Jan-V2/v3s_devboard/v3s_board.kicad_pcb

## KiCad design v3s_board.kicad_pcb (2022-10-17)

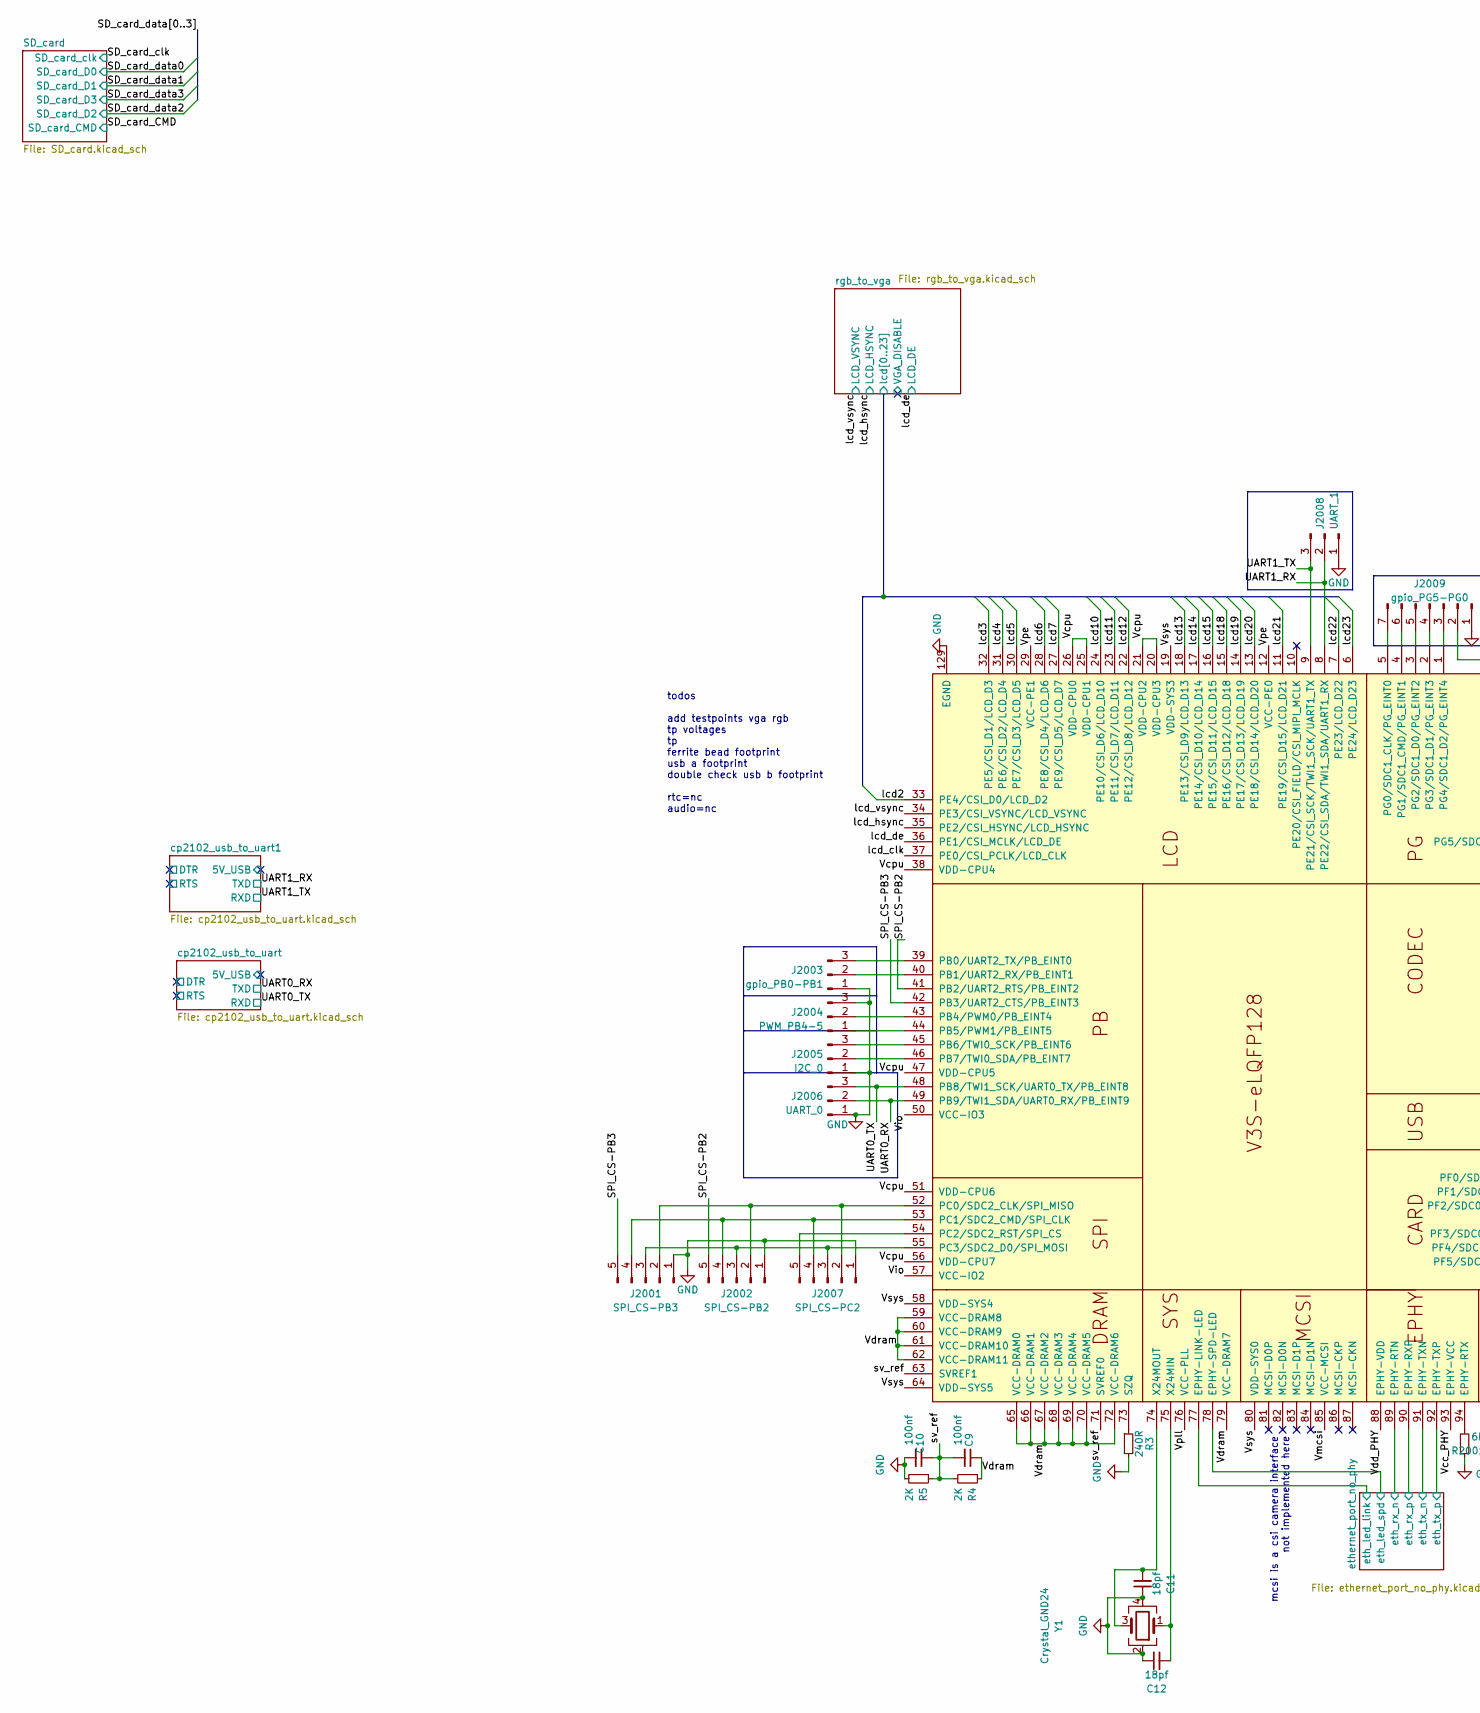
[picture p1: schematic v3s.kicad_sch, part in row 1, column 1]

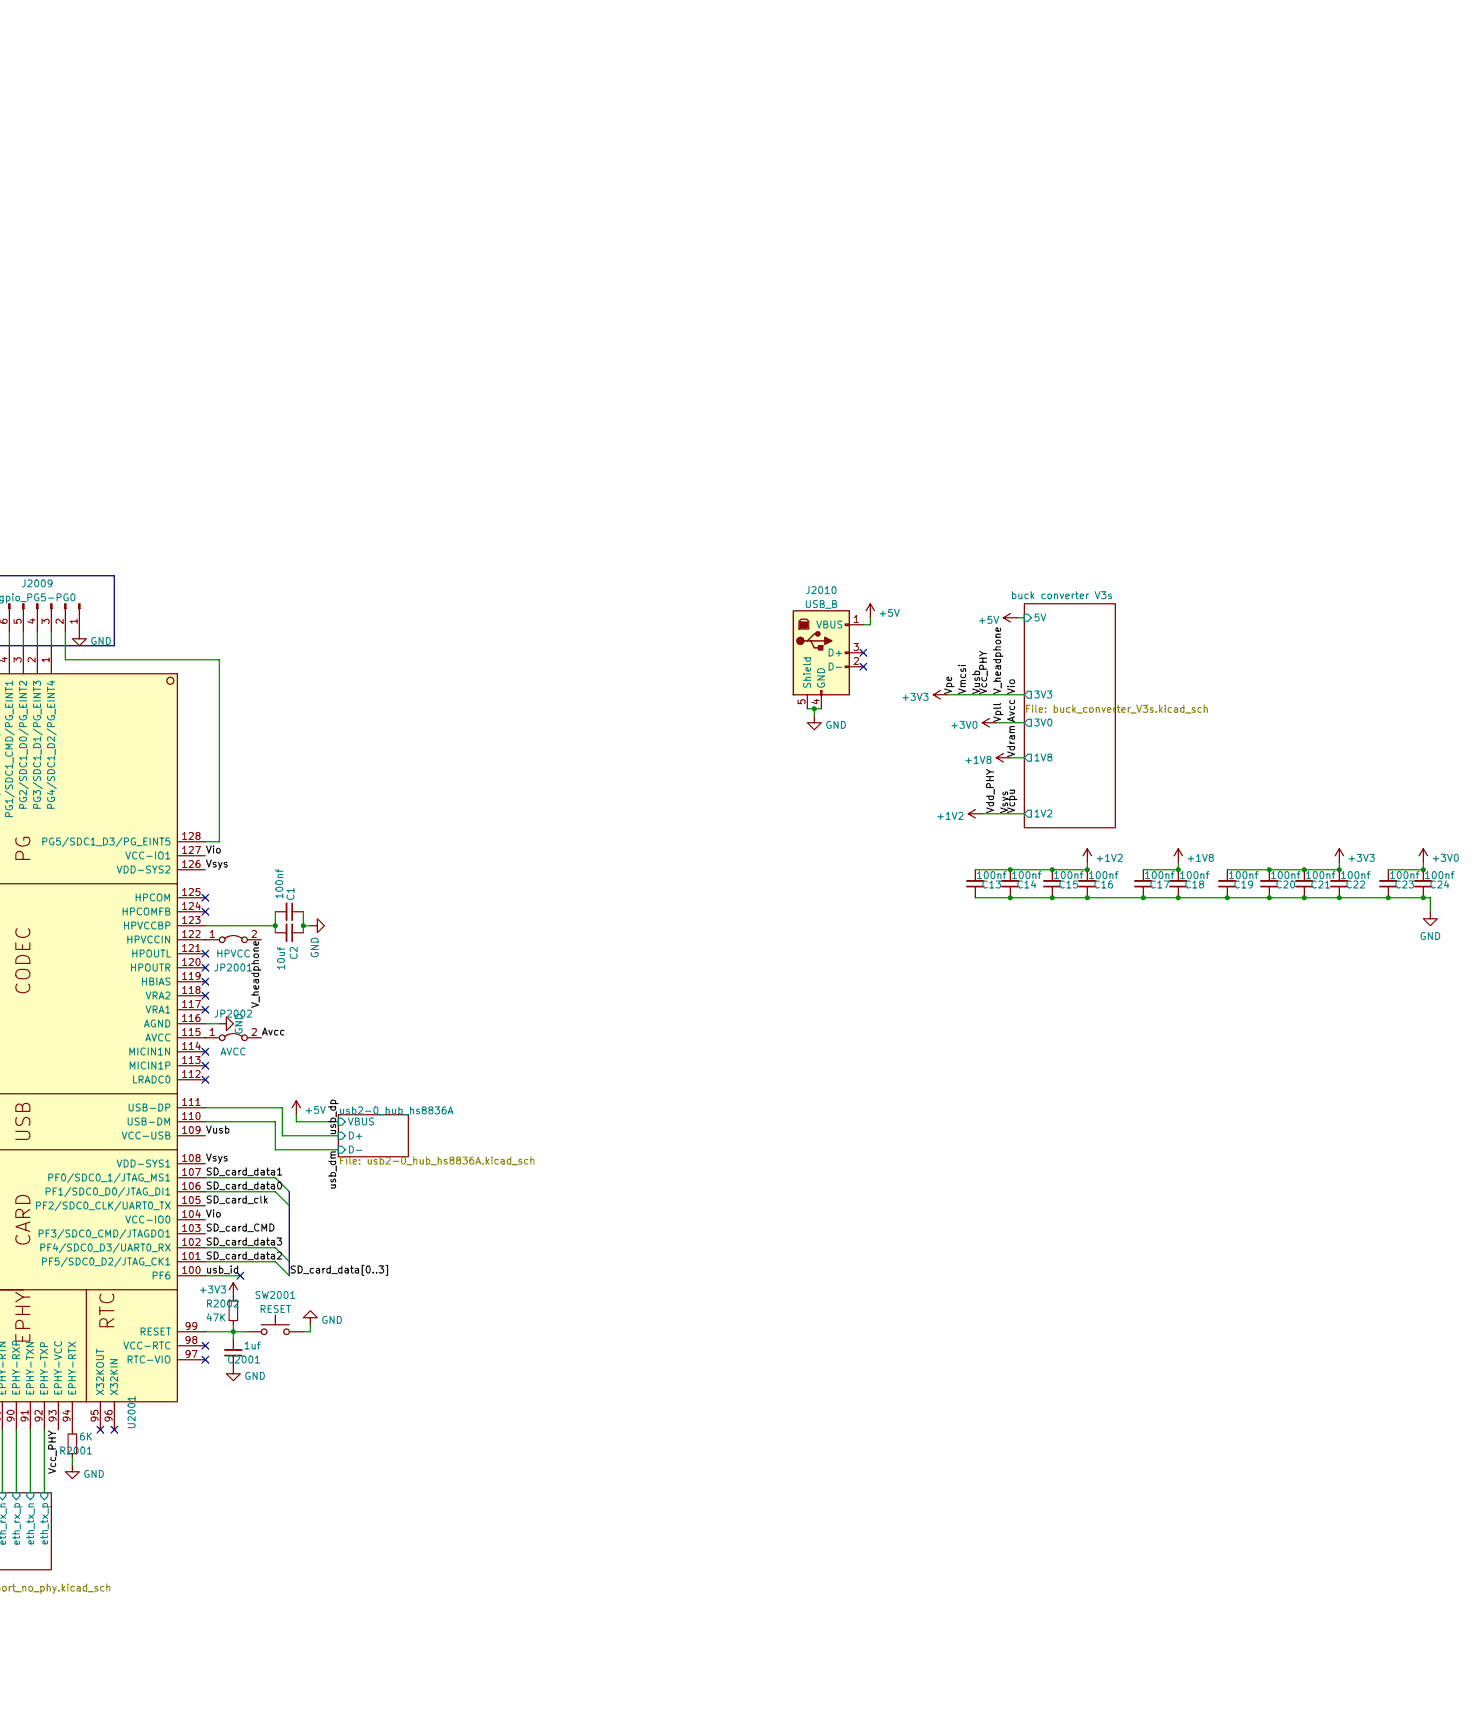
[picture p2: schematic v3s.kicad_sch, part in row 1, column 2]

Parts:
C1, C9, C10, C13, C14, C15, C16, C17, C18, C19, C20, C21, C22, C23, C24: 100nf; C_0603_1608Metric
C2: 10uf; C_0603_1608Metric
C11, C12: 18pf; C_0603_1608Metric
C2001: 1uf; C_0603_1608Metric
J2001: SPI_CS-PB3; PinHeader_1x05_P2.54mm_Vertical
J2002: SPI_CS-PB2; PinHeader_1x05_P2.54mm_Vertical
J2003: gpio_PB0-PB1; PinHeader_1x03_P2.54mm_Vertical
J2004: PWM_PB4-5; PinHeader_1x03_P2.54mm_Vertical
J2005: I2C_0; PinHeader_1x03_P2.54mm_Vertical
J2006: UART_0; PinHeader_1x03_P2.54mm_Vertical
J2007: SPI_CS-PC2; PinHeader_1x05_P2.54mm_Vertical
J2008: UART_1; PinHeader_1x03_P2.54mm_Vertical
J2009: gpio_PG5-PG0; PinHeader_1x07_P2.54mm_Vertical
J2010: USB_B; USB_B_TE_5787834_Vertical
JP2001: HPVCC; SolderJumper-2_P1.3mm_Bridged_Pad1.0x1.5mm
JP2002: AVCC; SolderJumper-2_P1.3mm_Bridged_Pad1.0x1.5mm
R3: 240R; R_0603_1608Metric
R4, R5: 2K; R_0603_1608Metric
R2001: 6K; R_0603_1608Metric
R2002: 47K; R_0603_1608Metric
SW2001: RESET; SW_PUSH_6mm
U2001: V3S; LQFP-128_14x14mm_P0.4mm
Y1: Crystal_GND24; Crystal_SMD_3225-4Pin_3.2x2.5mm_HandSoldering

Connections:
+1V2: C13.2, C14.2, C15.2, C16.2, U2001.19 (VDD-SYS3), U2001.20 (VDD-CPU3), U2001.21 (VDD-CPU2), U2001.25 (VDD-CPU1), U2001.26 (VDD-CPU0), U2001.38 (VDD-CPU4), U2001.47 (VDD-CPU5), U2001.51 (VDD-CPU6), U2001.56 (VDD-CPU7), U2001.58 (VDD-SYS4), U2001.64 (VDD-SYS5), U2001.80 (VDD-SYS0), U2001.88 (EPHY-VDD), U2001.108 (VDD-SYS1), U2001.126 (VDD-SYS2); also elsewhere on the board
+1V8: C9.1, C17.2, C18.2, R4.1, U2001.59 (VCC-DRAM8), U2001.60 (VCC-DRAM9), U2001.61 (VCC-DRAM10), U2001.62 (VCC-DRAM11), U2001.65 (VCC-DRAM0), U2001.66 (VCC-DRAM1), U2001.67 (VCC-DRAM2), U2001.68 (VCC-DRAM3), U2001.69 (VCC-DRAM4), U2001.70 (VCC-DRAM5), U2001.72 (VCC-DRAM6), U2001.79 (VCC-DRAM7); also elsewhere on the board
+3V0: C23.2, C24.2, JP2002.2 (B), U2001.76 (VCC-PLL); also elsewhere on the board
+3V3: C19.2, C20.2, C21.2, C22.2, JP2001.2 (B), R2002.1, U2001.12 (VCC-PE0), U2001.29 (VCC-PE1), U2001.50 (VCC-IO3), U2001.57 (VCC-IO2), U2001.85 (VCC-MCSI), U2001.93 (EPHY-VCC), U2001.104 (VCC-IO0), U2001.109 (VCC-USB), U2001.127 (VCC-IO1); also elsewhere on the board
+5V: J2010.1 (VBUS); also elsewhere on the board
/v3s/SD_card_CMD: U2001.103 (PF3/SDC0_CMD/JTAGDO1); also elsewhere on the board
/v3s/SD_card_clk: U2001.105 (PF2/SDC0_CLK/UART0_TX); also elsewhere on the board
/v3s/SD_card_data0: U2001.106 (PF1/SDC0_D0/JTAG_DI1); also elsewhere on the board
/v3s/SD_card_data1: U2001.107 (PF0/SDC0_1/JTAG_MS1); also elsewhere on the board
/v3s/SD_card_data2: U2001.101 (PF5/SDC0_D2/JTAG_CK1); also elsewhere on the board
/v3s/SD_card_data3: U2001.102 (PF4/SDC0_D3/UART0_RX); also elsewhere on the board
/v3s/SPI_CS-PB2: J2002.5, U2001.41 (PB2/UART2_RTS/PB_EINT2)
/v3s/SPI_CS-PB3: J2001.5, U2001.42 (PB3/UART2_CTS/PB_EINT3)
/v3s/UART0_RX: J2006.2, U2001.49 (PB9/TWI1_SDA/UART0_RX/PB_EINT9); also elsewhere on the board
/v3s/UART0_TX: J2006.3, U2001.48 (PB8/TWI1_SCK/UART0_TX/PB_EINT8); also elsewhere on the board
/v3s/UART1_RX: J2008.2, U2001.8 (PE22/CSI_SDA/TWI1_SDA/UART1_RX); also elsewhere on the board
/v3s/UART1_TX: J2008.3, U2001.9 (PE21/CSI_SCK/TWI1_SCK/UART1_TX); also elsewhere on the board
/v3s/ethernet_port_no_phy/eth_led_link: U2001.77 (EPHY-LINK-LED); also elsewhere on the board
/v3s/ethernet_port_no_phy/eth_led_spd: U2001.78 (EPHY-SPD-LED); also elsewhere on the board
/v3s/ethernet_port_no_phy/eth_rx_n: U2001.89 (EPHY-RTN); also elsewhere on the board
/v3s/ethernet_port_no_phy/eth_rx_p: U2001.90 (EPHY-RXP); also elsewhere on the board
/v3s/ethernet_port_no_phy/eth_tx_n: U2001.91 (EPHY-TXN); also elsewhere on the board
/v3s/ethernet_port_no_phy/eth_tx_p: U2001.92 (EPHY-TXP); also elsewhere on the board
/v3s/lcd_clk: U2001.37 (PE0/CSI_PCLK/LCD_CLK)
/v3s/lcd_de: U2001.36 (PE1/CSI_MCLK/LCD_DE); also elsewhere on the board
/v3s/lcd_hsync: U2001.35 (PE2/CSI_HSYNC/LCD_HSYNC); also elsewhere on the board
/v3s/lcd_vsync: U2001.34 (PE3/CSI_VSYNC/LCD_VSYNC); also elsewhere on the board
/v3s/rgb_to_vga/lcd2: U2001.33 (PE4/CSI_D0/LCD_D2); also elsewhere on the board
/v3s/rgb_to_vga/lcd3: U2001.32 (PE5/CSI_D1/LCD_D3); also elsewhere on the board
/v3s/rgb_to_vga/lcd4: U2001.31 (PE6/CSI_D2/LCD_D4); also elsewhere on the board
/v3s/rgb_to_vga/lcd5: U2001.30 (PE7/CSI_D3/LCD_D5); also elsewhere on the board
/v3s/rgb_to_vga/lcd6: U2001.28 (PE8/CSI_D4/LCD_D6); also elsewhere on the board
/v3s/rgb_to_vga/lcd7: U2001.27 (PE9/CSI_D5/LCD_D7); also elsewhere on the board
/v3s/rgb_to_vga/lcd10: U2001.24 (PE10/CSI_D6/LCD_D10); also elsewhere on the board
/v3s/rgb_to_vga/lcd11: U2001.23 (PE11/CSI_D7/LCD_D11); also elsewhere on the board
/v3s/rgb_to_vga/lcd12: U2001.22 (PE12/CSI_D8/LCD_D12); also elsewhere on the board
/v3s/rgb_to_vga/lcd13: U2001.18 (PE13/CSI_D9/LCD_D13); also elsewhere on the board
/v3s/rgb_to_vga/lcd14: U2001.17 (PE14/CSI_D10/LCD_D14); also elsewhere on the board
/v3s/rgb_to_vga/lcd15: U2001.16 (PE15/CSI_D11/LCD_D15); also elsewhere on the board
/v3s/rgb_to_vga/lcd18: U2001.15 (PE16/CSI_D12/LCD_D18); also elsewhere on the board
/v3s/rgb_to_vga/lcd19: U2001.14 (PE17/CSI_D13/LCD_D19); also elsewhere on the board
/v3s/rgb_to_vga/lcd20: U2001.13 (PE18/CSI_D14/LCD_D20); also elsewhere on the board
/v3s/rgb_to_vga/lcd21: U2001.11 (PE19/CSI_D15/LCD_D21); also elsewhere on the board
/v3s/rgb_to_vga/lcd22: U2001.7 (PE23/LCD_D22); also elsewhere on the board
/v3s/rgb_to_vga/lcd23: U2001.6 (PE24/LCD_D23); also elsewhere on the board
/v3s/sv_ref: C9.2, C10.1, R4.2, R5.1, U2001.63 (SVREF1), U2001.71 (SVREF0)
/v3s/usb_dm: U2001.110 (USB-DM); also elsewhere on the board
/v3s/usb_dp: U2001.111 (USB-DP); also elsewhere on the board
/v3s/usb_id: U2001.100 (PF6)
GND: C1.1, C2.1, C10.2, C11.1, C12.1, C13.1, C14.1, C15.1, C16.1, C17.1, C18.1, C19.1, C20.1, C21.1, C22.1, C23.1, C24.1, C2001.1, J2001.1, J2002.1, J2003.1, J2004.3, J2005.1, J2006.1, J2007.1, J2008.1, J2009.1, J2010.4 (GND), J2010.5 (Shield), R3.2, R5.2, R2001.1, SW2001.2, U2001.116 (AGND), U2001.129 (EGND), Y1.2, Y1.4; also elsewhere on the board
unnamed: C1.2, C2.2, U2001.123 (HPVCCBP)
unnamed: C11.2, U2001.74 (X24MOUT), Y1.3
unnamed: C12.2, U2001.75 (X24MIN), Y1.1
unnamed: C2001.2, R2002.2, SW2001.1, U2001.99 (RESET)
unnamed: J2001.2, J2002.2, J2007.2, U2001.52 (PC0/SDC2_CLK/SPI_MISO)
unnamed: J2001.3, J2002.3, J2007.3, U2001.55 (PC3/SDC2_D0/SPI_MOSI)
unnamed: J2001.4, J2002.4, J2007.4, U2001.53 (PC1/SDC2_CMD/SPI_CLK)
unnamed: J2003.2, U2001.40 (PB1/UART2_RX/PB_EINT1)
unnamed: J2003.3, U2001.39 (PB0/UART2_TX/PB_EINT0)
unnamed: J2004.1, U2001.44 (PB5/PWM1/PB_EINT5)
unnamed: J2004.2, U2001.43 (PB4/PWM0/PB_EINT4)
unnamed: J2005.2, U2001.46 (PB7/TWI0_SDA/PB_EINT7)
unnamed: J2005.3, U2001.45 (PB6/TWI0_SCK/PB_EINT6)
unnamed: J2007.5, U2001.54 (PC2/SDC2_RST/SPI_CS)
unnamed: J2009.2, U2001.128 (PG5/SDC1_D3/PG_EINT5)
unnamed: J2009.3, U2001.1 (PG4/SDC1_D2/PG_EINT4)
unnamed: J2009.4, U2001.2 (PG3/SDC1_D1/PG_EINT3)
unnamed: J2009.5, U2001.3 (PG2/SDC1_D0/PG_EINT2)
unnamed: J2009.6, U2001.4 (PG1/SDC1_CMD/PG_EINT1)
unnamed: J2009.7, U2001.5 (PG0/SDC1_CLK/PG_EINT0)
unnamed: JP2001.1 (A), U2001.122 (HPVCCIN)
unnamed: JP2002.1 (A), U2001.115 (AVCC)
unnamed: R3.1, U2001.73 (SZQ)
unnamed: R2001.2, U2001.94 (EPHY-RTX)

Notes on the sheet:
todos add testpoints vga rgb tp voltages tp ferrite bead footprint usb a footprint double check usb b footprint rtc=nc audio=nc
mcsi is a csi camera interface not implemented here

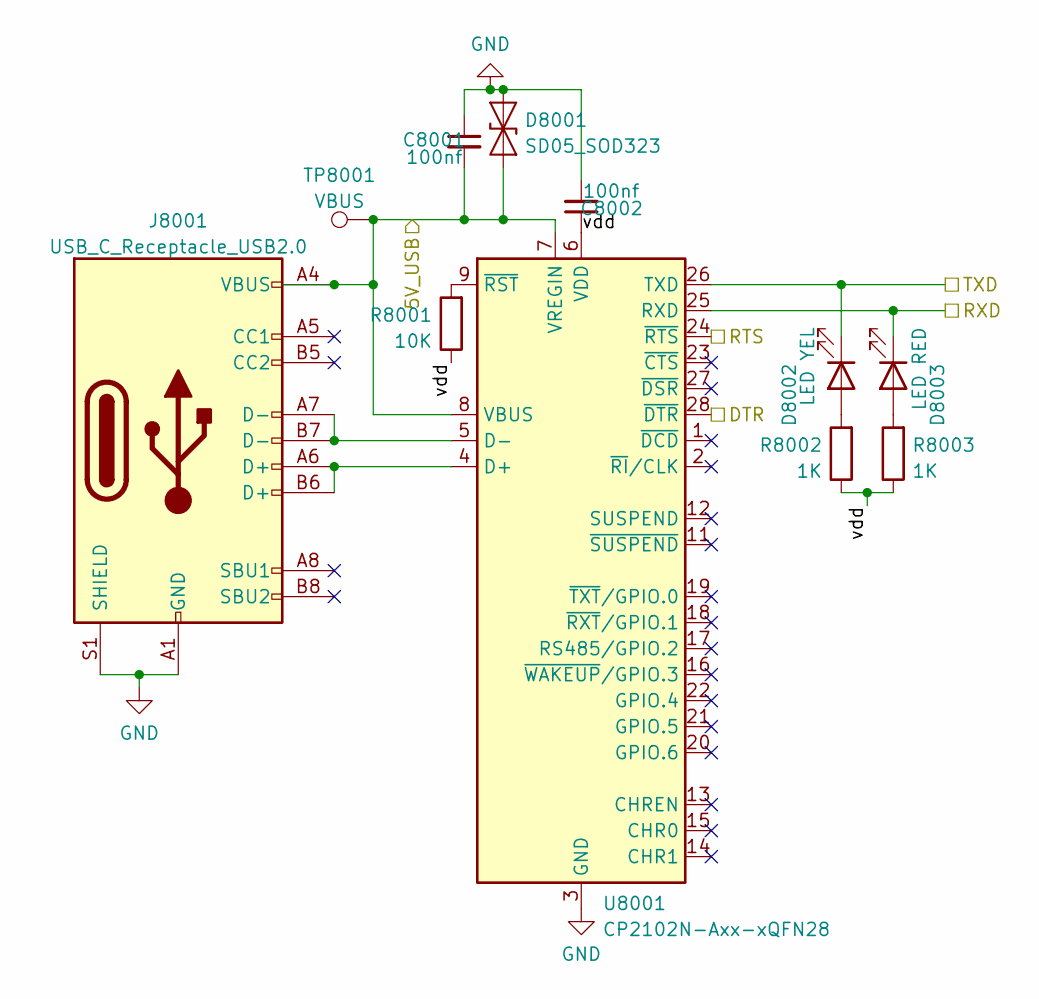
[picture p3: schematic cp2102_usb_to_uart.kicad_sch]

Parts:
C8001, C8002: 100nf; C_0603_1608Metric
D8001: SD05_SOD323; D_SOD-323
D8002: LED YEL; LED_0603_1608Metric
D8003: LED RED; LED_0603_1608Metric
J8001: USB_C_Receptacle_USB2.0; TYPE-C-31-M-14_top_mnt_usb2
R8001: 10K; R_0603_1608Metric
R8002, R8003: 1K; R_0603_1608Metric
TP8001: VBUS; TestPoint_Pad_D1.0mm
U8001: CP2102N-Axx-xQFN28; QFN-28-1EP_5x5mm_P0.5mm_EP3.35x3.35mm

Connections:
/v3s/UART1_RX: D8002.1 (K), U8001.26 (TXD); also elsewhere on the board
/v3s/UART1_TX: D8003.1 (K), U8001.25 (RXD); also elsewhere on the board
/v3s/cp2102_usb_to_uart1/5V_USB: C8001.2, D8001.1 (A1), J8001.A4 (VBUS), J8001.A9 (VBUS), J8001.B4 (VBUS), J8001.B9 (VBUS), TP8001.1, U8001.7 (VREGIN), U8001.8 (VBUS)
/v3s/cp2102_usb_to_uart1/DTR: U8001.28 (~DTR)
/v3s/cp2102_usb_to_uart1/RTS: U8001.24 (~RTS)
/v3s/cp2102_usb_to_uart1/vdd: C8002.1, R8001.1, R8002.1, R8003.1, U8001.6 (VDD)
GND: C8001.1, C8002.2, D8001.2 (A2), J8001.A1 (GND), J8001.A12 (GND), J8001.B1 (GND), J8001.B12 (GND), J8001.S1 (SHIELD), U8001.3 (GND), U8001.29 (GND); also elsewhere on the board
unnamed: D8002.2 (A), R8002.2
unnamed: D8003.2 (A), R8003.2
unnamed: J8001.A6 (D+), J8001.B6 (D+), U8001.4 (D+)
unnamed: J8001.A7 (D-), J8001.B7 (D-), U8001.5 (D-)
unnamed: R8001.2, U8001.9 (~RST)

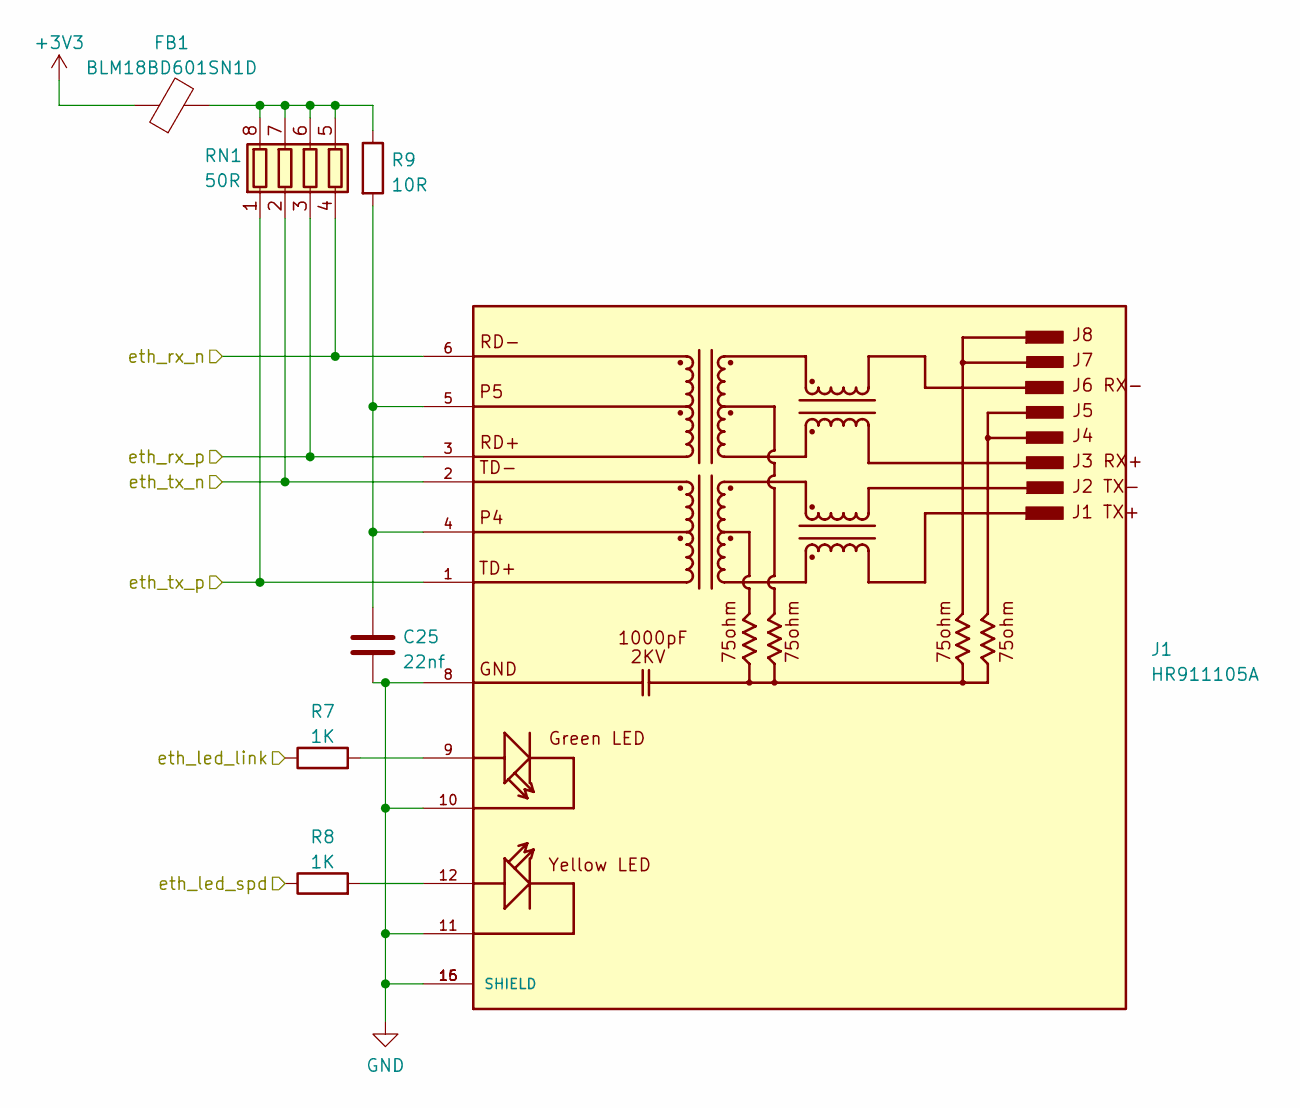
[picture p4: schematic ethernet_port_no_phy.kicad_sch]

Parts:
C25: 22nf; C_0603_1608Metric
FB1: BLM18BD601SN1D; C_0603_1608Metric
J1: HR911105A; HANRUN_HR911105A; PARTREV A
R7, R8: 1K; R_0603_1608Metric
R9: 10R; R_0603_1608Metric
RN1: 50R; R_Array_Concave_4x0603

Connections:
+3V3: FB1.1; also elsewhere on the board
/v3s/ethernet_port_no_phy/eth_led_link: R7.1; also elsewhere on the board
/v3s/ethernet_port_no_phy/eth_led_spd: R8.1; also elsewhere on the board
/v3s/ethernet_port_no_phy/eth_rx_n: J1.6, RN1.4 (R4.1); also elsewhere on the board
/v3s/ethernet_port_no_phy/eth_rx_p: J1.3, RN1.3 (R3.1); also elsewhere on the board
/v3s/ethernet_port_no_phy/eth_tx_n: J1.2, RN1.2 (R2.1); also elsewhere on the board
/v3s/ethernet_port_no_phy/eth_tx_p: J1.1, RN1.1 (R1.1); also elsewhere on the board
GND: C25.2, J1.8, J1.10, J1.11, J1.15 (SHIELD), J1.16 (SHIELD); also elsewhere on the board
unnamed: C25.1, J1.4, J1.5, R9.2
unnamed: FB1.2, R9.1, RN1.5 (R4.2), RN1.6 (R3.2), RN1.7 (R2.2), RN1.8 (R1.2)
unnamed: J1.9, R7.2
unnamed: J1.12, R8.2

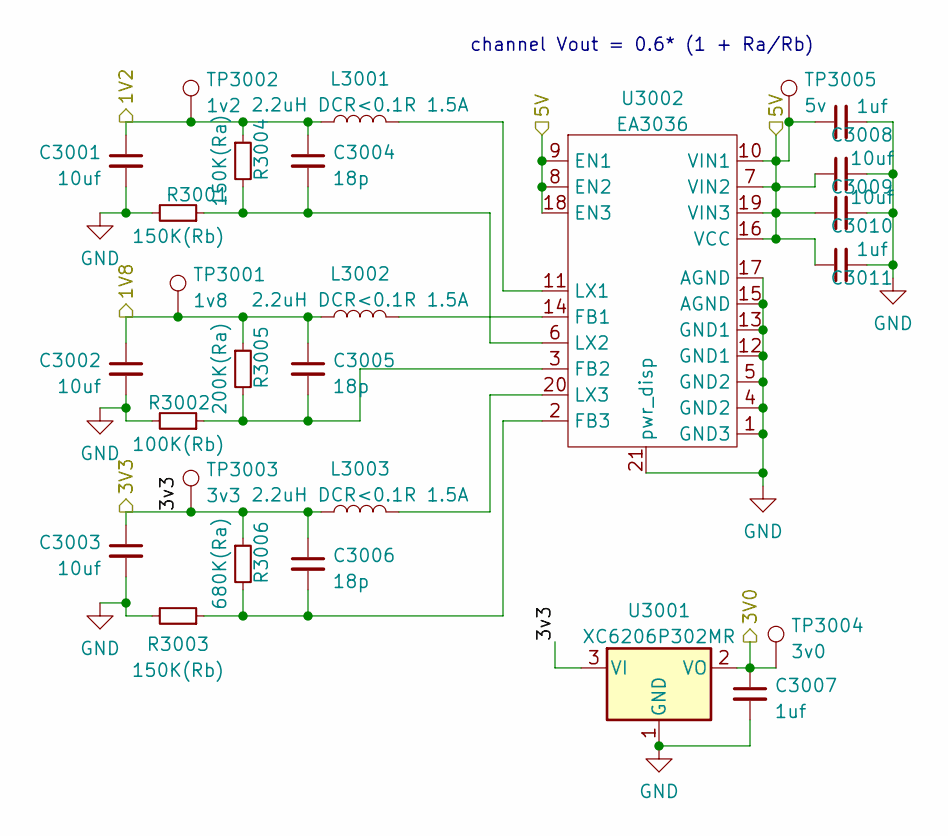
[picture p5: schematic buck_converter_V3s.kicad_sch]

Parts:
C3001, C3002, C3003, C3009, C3010: 10uf; C_0603_1608Metric
C3004, C3005, C3006: 18p; C_0603_1608Metric
C3007, C3008, C3011: 1uf; C_0603_1608Metric
L3001, L3002, L3003: 2.2uH DCR<0.1R 1.5A; L_1210_3225Metric
R3001, R3003: 150K(Rb); R_0603_1608Metric
R3002: 100K(Rb); R_0603_1608Metric
R3004: 150K(Ra); R_0603_1608Metric
R3005: 200K(Ra); R_0603_1608Metric
R3006: 680K(Ra); R_0603_1608Metric
TP3001: 1v8; TestPoint_Pad_D1.0mm
TP3002: 1v2; TestPoint_Pad_D1.0mm
TP3003: 3v3; TestPoint_Pad_D1.0mm
TP3004: 3v0; TestPoint_Pad_D1.0mm
TP3005: 5v; TestPoint_Pad_D1.0mm
U3001: XC6206P302MR; SOT-23
U3002: EA3036; QFN-20-1EP_3x3mm_P0.4mm_EP1.65x1.65mm

Connections:
+1V2: C3001.1, C3004.1, L3001.1, R3004.1, TP3002.1; also elsewhere on the board
+1V8: C3002.1, C3005.1, L3002.1, R3005.1, TP3001.1; also elsewhere on the board
+3V0: C3007.1, TP3004.1, U3001.2 (VO); also elsewhere on the board
+3V3: C3003.1, C3006.1, L3003.1, R3006.1, TP3003.1, U3001.3 (VI); also elsewhere on the board
+5V: C3008.1, C3009.1, C3010.1, C3011.1, TP3005.1, U3002.7 (VIN2), U3002.8 (EN2), U3002.9 (EN1), U3002.10 (VIN1), U3002.16 (VCC), U3002.18 (EN3), U3002.19 (VIN3); also elsewhere on the board
GND: C3001.2, C3002.2, C3003.2, C3007.2, C3008.2, C3009.2, C3010.2, C3011.2, R3001.2, R3002.2, R3003.2, U3001.1 (GND), U3002.1 (GND3), U3002.4 (GND2), U3002.5 (GND2), U3002.12 (GND1), U3002.13 (GND1), U3002.15 (AGND), U3002.17 (AGND), U3002.21 (pwr_disp); also elsewhere on the board
unnamed: C3004.2, R3001.1, R3004.2, U3002.6 (LX2)
unnamed: C3005.2, R3002.1, R3005.2, U3002.3 (FB2)
unnamed: C3006.2, R3003.1, R3006.2, U3002.2 (FB3)
unnamed: L3001.2, U3002.11 (LX1)
unnamed: L3002.2, U3002.14 (FB1)
unnamed: L3003.2, U3002.20 (LX3)

Notes on the sheet:
channel Vout = 0.6* (1 + Ra/Rb)

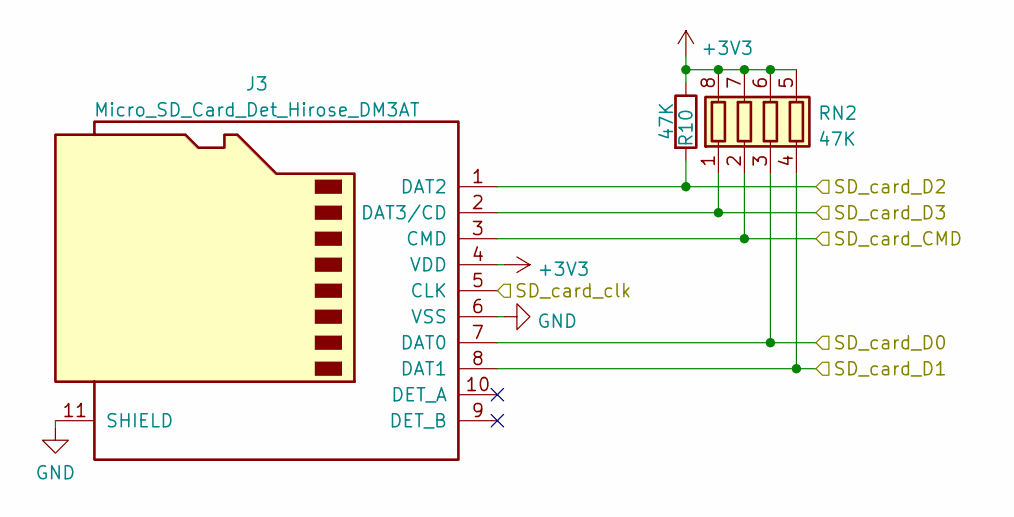
[picture p6: schematic SD_card.kicad_sch]

Parts:
J3: Micro_SD_Card_Det_Hirose_DM3AT; microSD_HC_Hirose_DM3AT-SF-PEJM5
R10: 47K; R_0603_1608Metric
RN2: 47K; R_Array_Concave_4x0603

Connections:
+3V3: J3.4 (VDD), R10.1, RN2.5 (R4.2), RN2.6 (R3.2), RN2.7 (R2.2), RN2.8 (R1.2); also elsewhere on the board
/v3s/SD_card_CMD: J3.3 (CMD), RN2.2 (R2.1); also elsewhere on the board
/v3s/SD_card_clk: J3.5 (CLK); also elsewhere on the board
/v3s/SD_card_data0: J3.7 (DAT0), RN2.3 (R3.1); also elsewhere on the board
/v3s/SD_card_data1: J3.8 (DAT1), RN2.4 (R4.1); also elsewhere on the board
/v3s/SD_card_data2: J3.1 (DAT2), R10.2; also elsewhere on the board
/v3s/SD_card_data3: J3.2 (DAT3/CD), RN2.1 (R1.1); also elsewhere on the board
GND: J3.6 (VSS), J3.11 (SHIELD); also elsewhere on the board

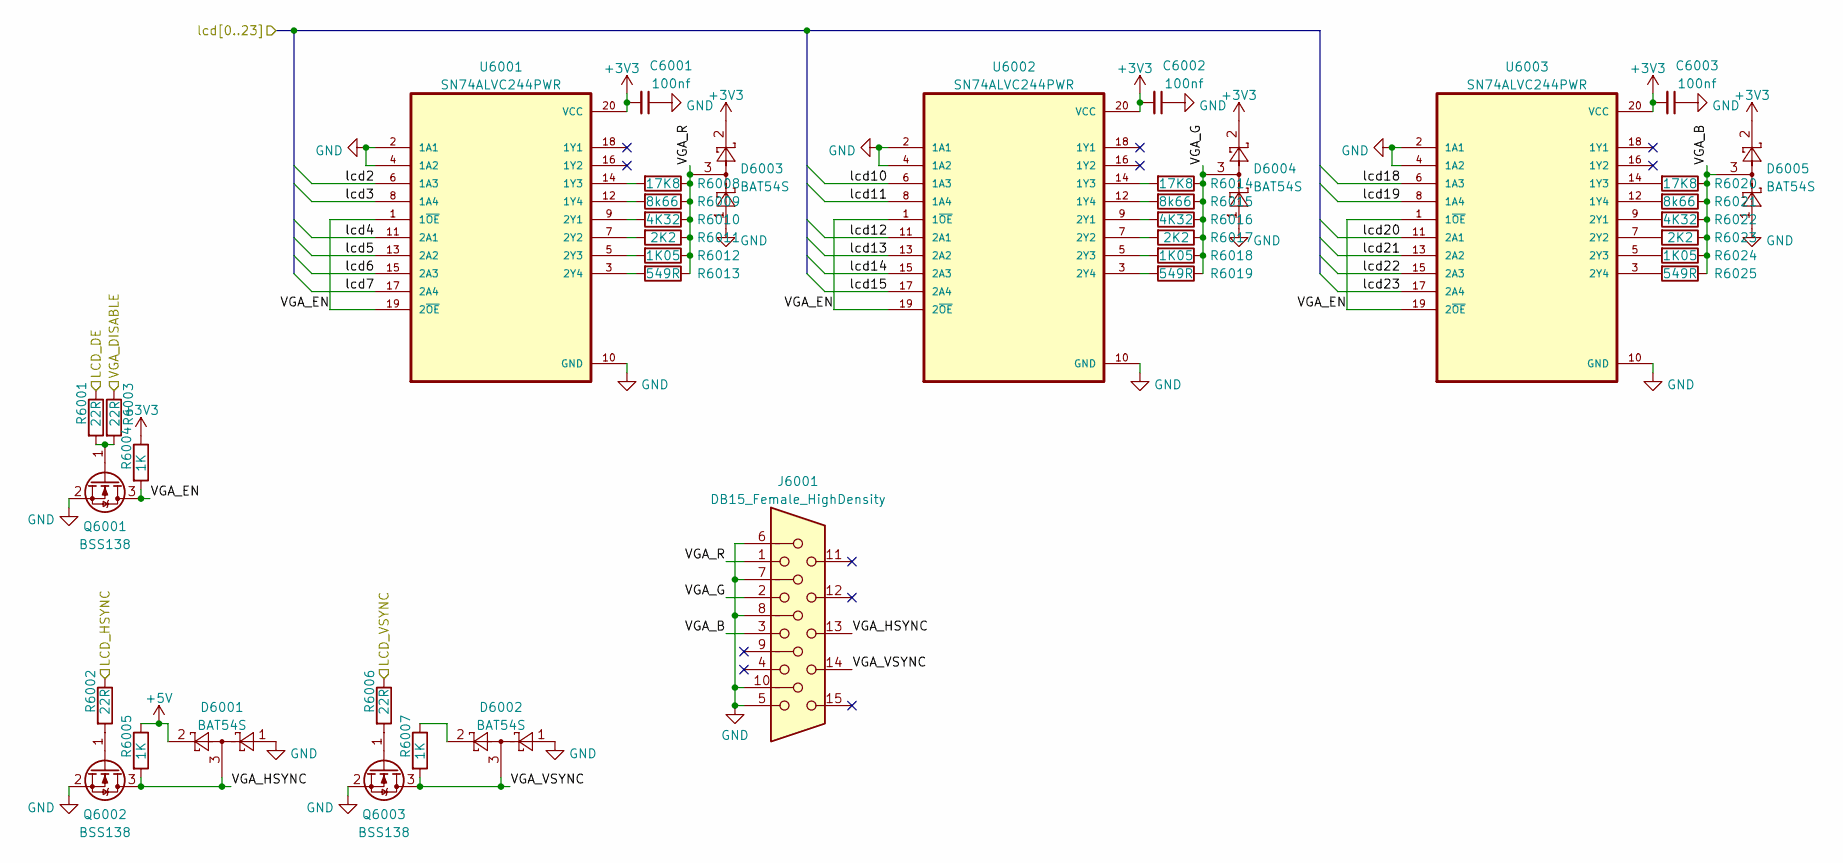
[picture p7: schematic rgb_to_vga.kicad_sch]

Parts:
C6001, C6002, C6003: 100nf; C_0603_1608Metric
D6001, D6002, D6003, D6004, D6005: BAT54S; SOT-23
J6001: DB15_Female_HighDensity; DSUB-15-HD_Female_Horizontal_P2.29x1.98mm_EdgePinOffset3.03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
Q6001, Q6002, Q6003: BSS138; SOT-23
R6001, R6002, R6003, R6006: 22R; R_0603_1608Metric
R6004, R6005, R6007: 1K; R_0603_1608Metric
R6008, R6014, R6020: 17K8; R_0402_1005Metric
R6009, R6015, R6021: 8k66; R_0402_1005Metric
R6010, R6016, R6022: 4K32; R_0402_1005Metric
R6011, R6017, R6023: 2K2; R_0402_1005Metric
R6012, R6018, R6024: 1K05; R_0402_1005Metric
R6013, R6019, R6025: 549R; R_0402_1005Metric
U6001, U6002, U6003: SN74ALVC244PWR; SOP-20_7.5x12.8mm_P1.27mm

Connections:
+3V3: C6001.2, C6002.2, C6003.2, D6003.2, D6004.2, D6005.2, R6004.1, U6001.20 (VCC), U6002.20 (VCC), U6003.20 (VCC); also elsewhere on the board
+5V: D6001.2, R6005.1; also elsewhere on the board
/v3s/lcd_de: R6001.1; also elsewhere on the board
/v3s/lcd_hsync: R6002.1; also elsewhere on the board
/v3s/lcd_vsync: R6006.1; also elsewhere on the board
/v3s/rgb_to_vga/VGA_B: D6005.3, J6001.3, R6020.1, R6021.1, R6022.1, R6023.1, R6024.1, R6025.1
/v3s/rgb_to_vga/VGA_DISABLE: R6003.1
/v3s/rgb_to_vga/VGA_EN: Q6001.3 (D), R6004.2, U6001.1 (1~OE), U6001.19 (2~OE), U6002.1 (1~OE), U6002.19 (2~OE), U6003.1 (1~OE), U6003.19 (2~OE)
/v3s/rgb_to_vga/VGA_G: D6004.3, J6001.2, R6014.1, R6015.1, R6016.1, R6017.1, R6018.1, R6019.1
/v3s/rgb_to_vga/VGA_HSYNC: D6001.3, J6001.13, Q6002.3 (D), R6005.2
/v3s/rgb_to_vga/VGA_R: D6003.3, J6001.1, R6008.1, R6009.1, R6010.1, R6011.1, R6012.1, R6013.1
/v3s/rgb_to_vga/VGA_VSYNC: D6002.3, J6001.14, Q6003.3 (D), R6007.2
/v3s/rgb_to_vga/lcd2: U6001.6 (1A3); also elsewhere on the board
/v3s/rgb_to_vga/lcd3: U6001.8 (1A4); also elsewhere on the board
/v3s/rgb_to_vga/lcd4: U6001.11 (2A1); also elsewhere on the board
/v3s/rgb_to_vga/lcd5: U6001.13 (2A2); also elsewhere on the board
/v3s/rgb_to_vga/lcd6: U6001.15 (2A3); also elsewhere on the board
/v3s/rgb_to_vga/lcd7: U6001.17 (2A4); also elsewhere on the board
/v3s/rgb_to_vga/lcd10: U6002.6 (1A3); also elsewhere on the board
/v3s/rgb_to_vga/lcd11: U6002.8 (1A4); also elsewhere on the board
/v3s/rgb_to_vga/lcd12: U6002.11 (2A1); also elsewhere on the board
/v3s/rgb_to_vga/lcd13: U6002.13 (2A2); also elsewhere on the board
/v3s/rgb_to_vga/lcd14: U6002.15 (2A3); also elsewhere on the board
/v3s/rgb_to_vga/lcd15: U6002.17 (2A4); also elsewhere on the board
/v3s/rgb_to_vga/lcd18: U6003.6 (1A3); also elsewhere on the board
/v3s/rgb_to_vga/lcd19: U6003.8 (1A4); also elsewhere on the board
/v3s/rgb_to_vga/lcd20: U6003.11 (2A1); also elsewhere on the board
/v3s/rgb_to_vga/lcd21: U6003.13 (2A2); also elsewhere on the board
/v3s/rgb_to_vga/lcd22: U6003.15 (2A3); also elsewhere on the board
/v3s/rgb_to_vga/lcd23: U6003.17 (2A4); also elsewhere on the board
GND: C6001.1, C6002.1, C6003.1, D6001.1, D6002.1, D6003.1, D6004.1, D6005.1, J6001.5, J6001.6, J6001.7, J6001.8, J6001.10, Q6001.2 (S), Q6002.2 (S), Q6003.2 (S), U6001.2 (1A1), U6001.4 (1A2), U6001.10 (GND), U6002.2 (1A1), U6002.4 (1A2), U6002.10 (GND), U6003.2 (1A1), U6003.4 (1A2), U6003.10 (GND); also elsewhere on the board
unnamed: D6002.2, R6007.1
unnamed: Q6001.1 (G), R6001.2, R6003.2
unnamed: Q6002.1 (G), R6002.2
unnamed: Q6003.1 (G), R6006.2
unnamed: R6008.2, U6001.14 (1Y3)
unnamed: R6009.2, U6001.12 (1Y4)
unnamed: R6010.2, U6001.9 (2Y1)
unnamed: R6011.2, U6001.7 (2Y2)
unnamed: R6012.2, U6001.5 (2Y3)
unnamed: R6013.2, U6001.3 (2Y4)
unnamed: R6014.2, U6002.14 (1Y3)
unnamed: R6015.2, U6002.12 (1Y4)
unnamed: R6016.2, U6002.9 (2Y1)
unnamed: R6017.2, U6002.7 (2Y2)
unnamed: R6018.2, U6002.5 (2Y3)
unnamed: R6019.2, U6002.3 (2Y4)
unnamed: R6020.2, U6003.14 (1Y3)
unnamed: R6021.2, U6003.12 (1Y4)
unnamed: R6022.2, U6003.9 (2Y1)
unnamed: R6023.2, U6003.7 (2Y2)
unnamed: R6024.2, U6003.5 (2Y3)
unnamed: R6025.2, U6003.3 (2Y4)

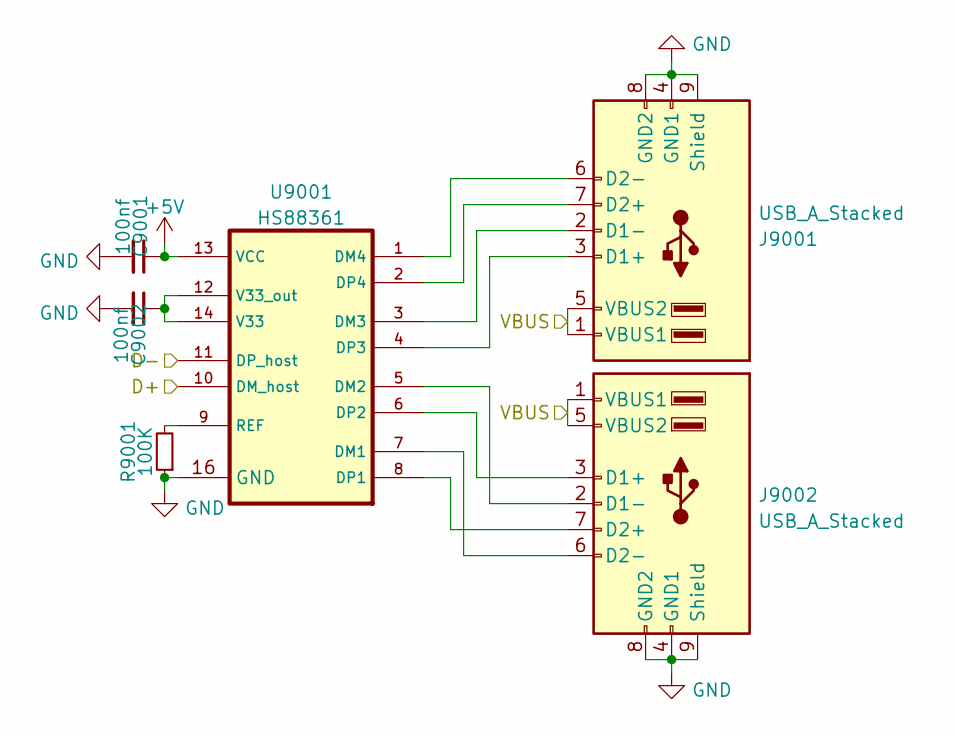
[picture p8: schematic usb2-0_hub_hs8836A.kicad_sch]

Parts:
C9001, C9002: 100nf; C_0603_1608Metric
J9001, J9002: USB_A_Stacked; USB_A_Wuerth_61400826021_Horizontal_Stacked
R9001: 100K; R_0603_1608Metric
U9001: HS88361; SO-16_3.9x9.9mm_P1.27mm

Connections:
+5V: C9001.1, J9001.1 (VBUS1), J9001.5 (VBUS2), J9002.1 (VBUS1), J9002.5 (VBUS2), U9001.13 (VCC); also elsewhere on the board
/v3s/usb_dm: U9001.11 (DP_host); also elsewhere on the board
/v3s/usb_dp: U9001.10 (DM_host); also elsewhere on the board
GND: C9001.2, C9002.2, J9001.4 (GND1), J9001.8 (GND2), J9001.9 (Shield), J9002.4 (GND1), J9002.8 (GND2), J9002.9 (Shield), R9001.1, U9001.16 (GND); also elsewhere on the board
unnamed: C9002.1, U9001.12 (V33_out), U9001.14 (V33)
unnamed: J9001.2 (D1-), U9001.3 (DM3)
unnamed: J9001.3 (D1+), U9001.4 (DP3)
unnamed: J9001.6 (D2-), U9001.1 (DM4)
unnamed: J9001.7 (D2+), U9001.2 (DP4)
unnamed: J9002.2 (D1-), U9001.5 (DM2)
unnamed: J9002.3 (D1+), U9001.6 (DP2)
unnamed: J9002.6 (D2-), U9001.7 (DM1)
unnamed: J9002.7 (D2+), U9001.8 (DP1)
unnamed: R9001.2, U9001.9 (REF)
