Jan-V2/v3s_devboard/v3s_board.kicad_pcb

## KiCad design v3s_board.kicad_pcb (continued)

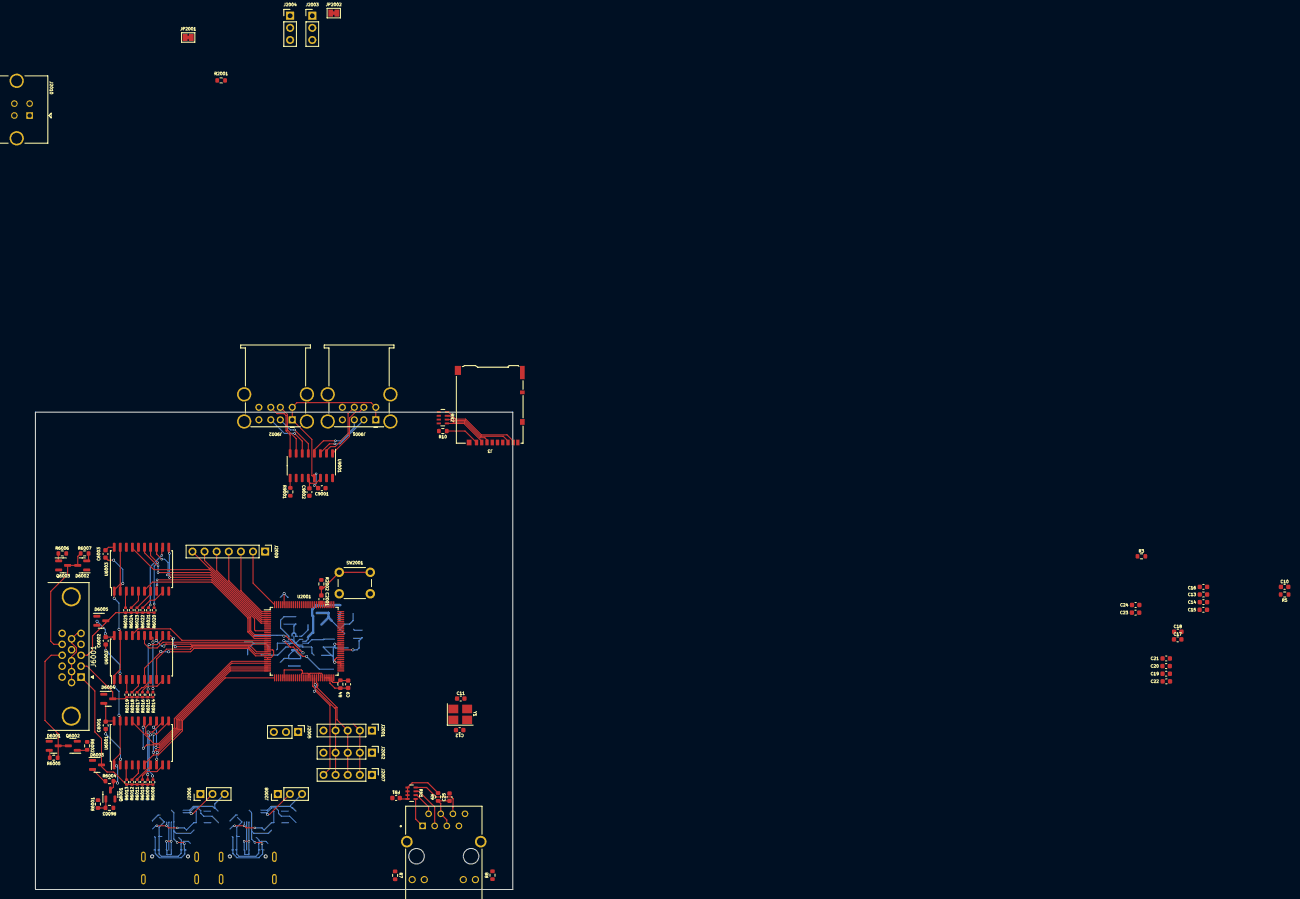
[picture p9: board v3s_board.kicad_pcb from above]

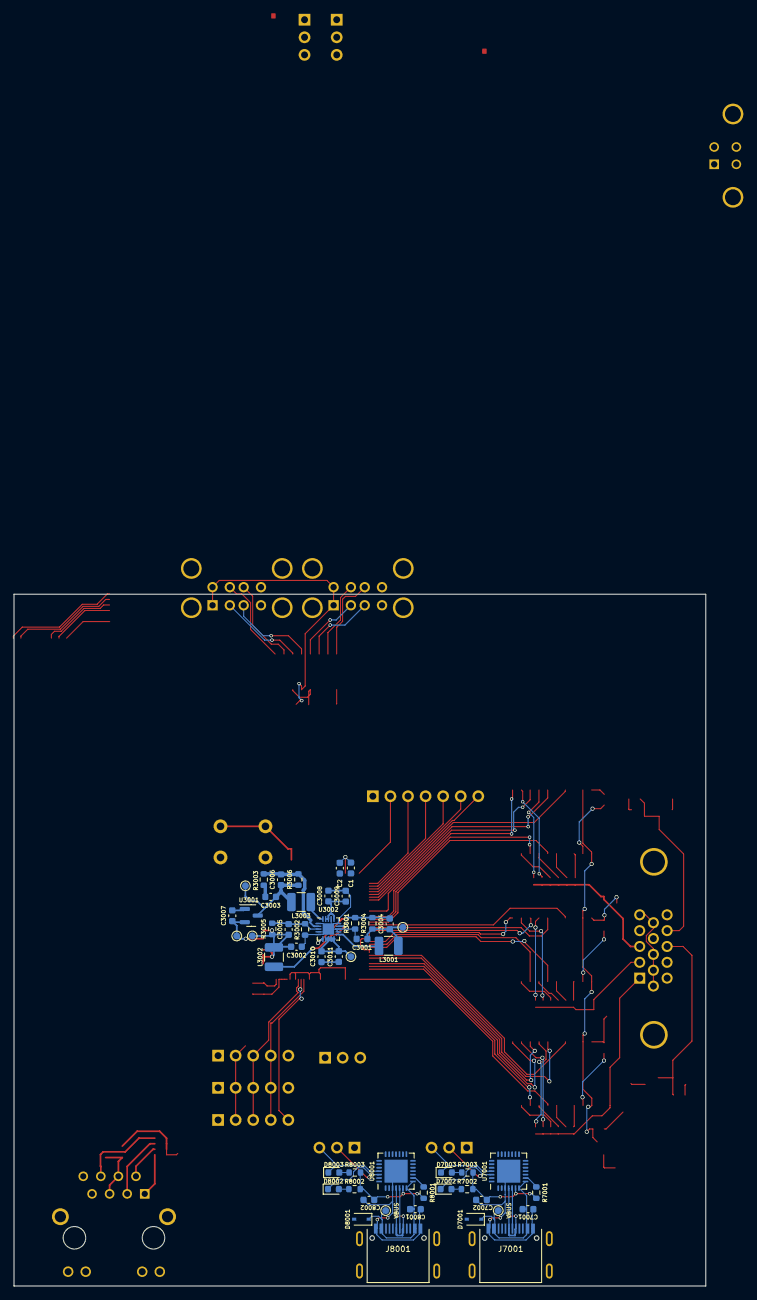
[picture p10: board v3s_board.kicad_pcb from below]

Board: 4 copper layers, 100.0 x 100.0 mm, 144 parts (51 on the bottom side), 134 nets.

Other parts of the board:
C7001, C7002: 100nf; C_0603_1608Metric
D7001: SD05_SOD323; D_SOD-323
D7002: LED YEL; LED_0603_1608Metric
D7003: LED RED; LED_0603_1608Metric
J7001: USB_C_Receptacle_USB2.0; TYPE-C-31-M-14_top_mnt_usb2
R7001: 10K; R_0603_1608Metric
R7002, R7003: 1K; R_0603_1608Metric
TP7001: VBUS; TestPoint_Pad_D1.0mm
U7001: CP2102N-Axx-xQFN28; QFN-28-1EP_5x5mm_P0.5mm_EP3.35x3.35mm

Their connections:
/v3s/UART0_RX: D7002.1 (K), U7001.26 (TXD); also elsewhere on the board
/v3s/UART0_TX: D7003.1 (K), U7001.25 (RXD); also elsewhere on the board
/v3s/cp2102_usb_to_uart/5V_USB: C7001.2, D7001.1 (A1), J7001.A4 (VBUS), J7001.A9 (VBUS), J7001.B4 (VBUS), J7001.B9 (VBUS), TP7001.1, U7001.7 (VREGIN), U7001.8 (VBUS)
/v3s/cp2102_usb_to_uart/vdd: C7002.1, R7001.1, R7002.1, R7003.1, U7001.6 (VDD)
GND: C7001.1, C7002.2, D7001.2 (A2), J7001.A1 (GND), J7001.A12 (GND), J7001.B1 (GND), J7001.B12 (GND), J7001.S1 (SHIELD), U7001.3 (GND), U7001.29 (GND); also elsewhere on the board
unnamed: D7002.2 (A), R7002.2
unnamed: D7003.2 (A), R7003.2
unnamed: J7001.A6 (D+), J7001.B6 (D+), U7001.4 (D+)
unnamed: J7001.A7 (D-), J7001.B7 (D-), U7001.5 (D-)
unnamed: R7001.2, U7001.9 (~RST)
