Jan-V2/v3s_devboard/(commit log)

2022-10-16 almost done
    [SD_card.kicad_sch, buck_converter_V3s.kicad_sch, cp2102_usb_to_uart.kicad_sch, ethernet_port_no_phy.kicad_sch, rgb_to_vga.kicad_sch, usb2-0_hub_hs8836A.kicad_sch, v3s.kicad_sch, v3s_board.kicad_pcb]
2022-10-17 minor chantes
    [v3s.kicad_sch, v3s_board.kicad_pcb]
